OpenReloading/AutoLever/docs/index.md

---
title: Introduction
hide: [navigation, toc]
---

<div class="hero-label">Pre-release, October 2026</div>

# AutoLever: pneumatic drive for the Lee APP

!!! danger "Safety"

    --8<-- "safety.md"

Give your Lee APP an air-powered upgrade. AutoLever takes over the lever work for sizing and decapping. Press START and a Festo cylinder keeps it cycling, stroke after stroke. Press START again when you’re done.

[Start with the BOM](bom.md){ .md-button .md-button--primary } [Wiring](wiring.md){ .md-button }

!!! warning "Status"

    Nothing has been built yet, the printed parts are not on MakerWorld yet, details will change. The StamPLC firmware and wiring have passed their automated tests only; the bench check on the real unit is still open.

!!! note "Relay edition (deprecated prototype)"

    The first prototype used four relays and a timer. Its guide stays as the [relay edition](relay.md) until the parts are removed; do not start a new build from it.

- **One controller, two sensors.** An M5Stack StamPLC runs the sequence.
- **Open firmware.** Flash it once over USB-C with PlatformIO; later updates go over Wi-Fi.
- **Free plans.** Bring your press and build your own.
- **7 to 10 bar** compressed-air supply

Built by reloaders for reloaders, with AI as a tool.

## What it does

- **Automatic cycling.** Press START once for continuous out-and-back strokes. Press it again to stop after the current stroke.
- **JOG control.** With automatic mode off, hold JOG to cycle. Release it to stop.
- **Free at rest.** The cylinder vents when the valve is off, so you can move the lever by hand.
- **Cycle monitoring.** A stroke that takes longer than the jam time (15 s, set between 2 and 120 s on the web page) stops the press, in automatic mode and in JOG, until you press A. Both sensors on at once is a sensor fault.
- **Pressure trip.** The pressure switch cuts power to the valves at 6 bar.
- **Cycle counter.** The display and the web page show the cycles, kept across power-off.
- **Web page.** The StamPLC opens its own Wi-Fi and joins your home network; the page shows the state and sets the jam time. Password and address are on the info screen.
- **24 V throughout.** An enclosed external power supply powers the controls.

## At the controls

POWER and the three buttons under the display:

1. **POWER** on.
2. **A** starts and stops automatic cycling.
3. **B** jogs while held.
4. **C** shows the info screen.

E-STOP cuts the power to the valves (the StamPLC stays on and shows the fault); twist to release. A supply fault clears itself when the power is back; after a jam or a sensor fault, press A, also when E-STOP or the pressure switch tripped in between. Release JOG after any stop or trip. A held JOG never starts the press; release it and press it again.

Check the printed handle adapter for cracks before each session.

## What you’ll need

- A Lee APP (Classic preferred; Deluxe also works).
- A compressed-air supply at 7 to 10 bar.
- The BOM parts, plus a printed handle adapter, control box and yellow E-STOP ring, and a computer with [PlatformIO](https://platformio.org/) to flash the StamPLC (project folder `firmware/` in the repository).

## Print it

PETG or ASA. Handle adapter: 6 walls and 40% infill. Control box: 15–20% infill. The base and lid fit on a 256 mm bed. Print the E-STOP ring in yellow.

!!! danger "Safety"

    --8<-- "safety-short.md"

## Build it

1. Print the parts and gather the components from the [BOM](bom.md).
2. Mount the press, cylinder, valve and filter-regulator on a board. Clamp the handle adapter onto the press lever.
3. Follow the [Wiring](wiring.md) and [Tubing](tubing.md) guides to connect everything.
4. Flash the bench image (`pio run -e bench -t upload` in `firmware/`): it shows BENCH and all eight inputs live, and A, B and C toggle relays 1, 2 and 3. All relays switch off by themselves once one has been on for 10 s, and while input 3 or 4 is off. Set the sensors with air disconnected: POWER on, move the rod by hand. Then flash the press firmware (`pio run -e stamplc -t upload`) and test with air at 2 bar using JOG before trying START.

## Update it

Later updates go over Wi-Fi, once the press firmware is on the StamPLC (the bench image has none). The display must show IDLE: the update is closed while the press runs, jogs or shows a fault. Press C and run in `firmware/`, with the password from the **Pass** line:

    PLATFORMIO_UPLOAD_FLAGS=--auth=PASSWORD pio run -e stamplc -t upload --upload-port autolever.local

This form is for Linux and macOS shells. In PowerShell, run `$env:PLATFORMIO_UPLOAD_FLAGS="--auth=PASSWORD"` once in the session, then the same `pio` command without the prefix.

PlatformIO warns that it switched to `espota`; that is expected. If `autolever.local` is not found, use the address on the **Home** line; when Home shows `-`, join the StamPLC's own Wi-Fi (the **Wi-Fi** line) and use `192.168.4.1`. The StamPLC connects back to your computer during the upload, so allow it if a firewall asks. USB-C stays the recovery path: if an update fails or the press does not start, flash it as in step 4.

<div class="change-it" markdown>

## Change it

Edit `data/*.yaml`, run `.venv/bin/python main.py` and commit `data/buildguide.json`. Printable parts are in `cad/`.

    python -m venv .venv && .venv/bin/pip install -r requirements.txt
    .venv/bin/python main.py
    .venv/bin/mkdocs serve

</div>
