OpenReloading/AutoLever/docs/relay.md

---
hide: [navigation, toc]
---

# Wiring (relay edition)

!!! danger "Safety"

    --8<-- "safety-short.md"

    The full warning is on the [introduction page](index.md).

!!! warning "Deprecated prototype"

    This is the prototype with four relays and a jam timer. It is kept until the relays and the timer are removed from the project, then this page goes too. Build the [StamPLC edition](wiring.md) instead; the parts for this one are in the BOM under "Relay edition only".
