OpenReloading/AutoLever/docs/tubing.md

---
title: Tubing
hide: [navigation, toc, footer]
---

<div id="assembly-guide" data-page="tubing"><noscript>This guide needs JavaScript.</noscript></div>
{{ guide_data() }}
<script src="../assets/guide.js" defer></script>
