OpenReloading/AutoLever/docs/assets/boxes/control_box.png

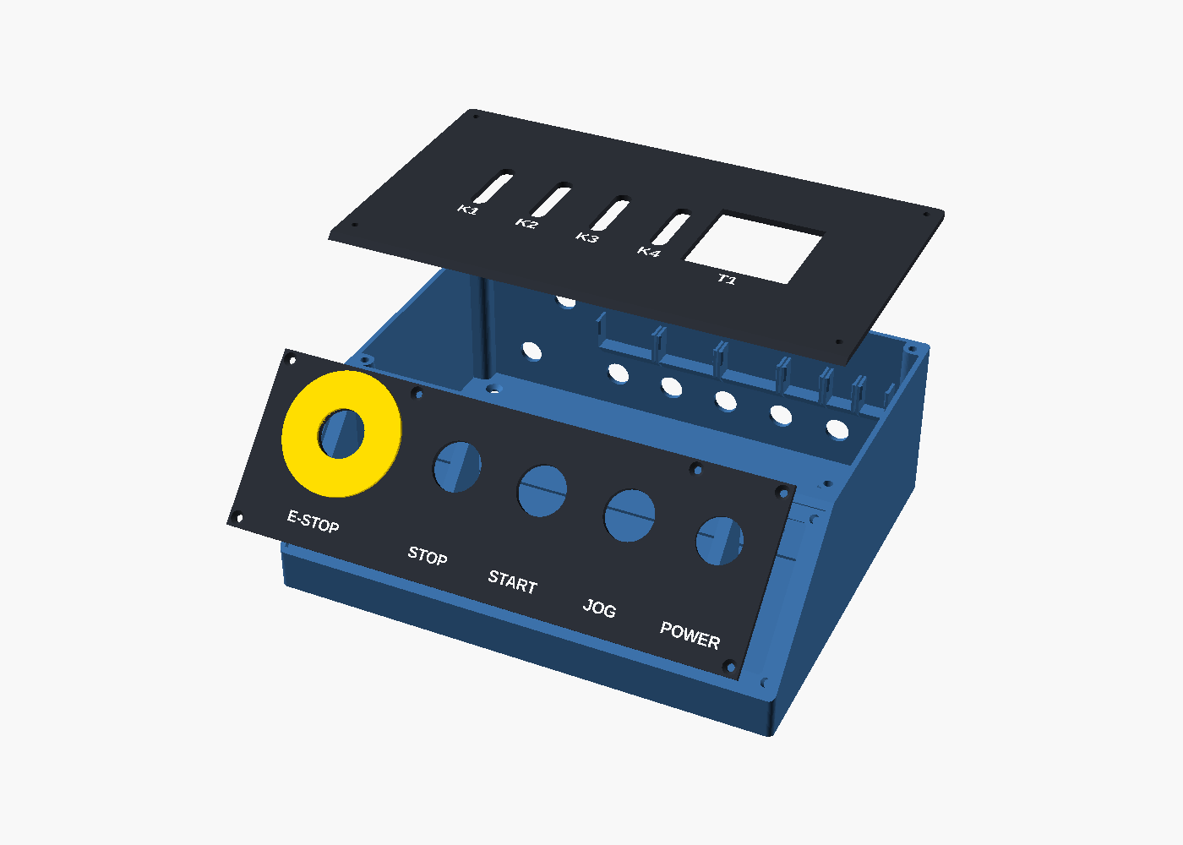
docs/assets/boxes/control_box.png
