OpenReloading/AutoLever/docs/assets/boxes/lee_app_handle_adapter.png

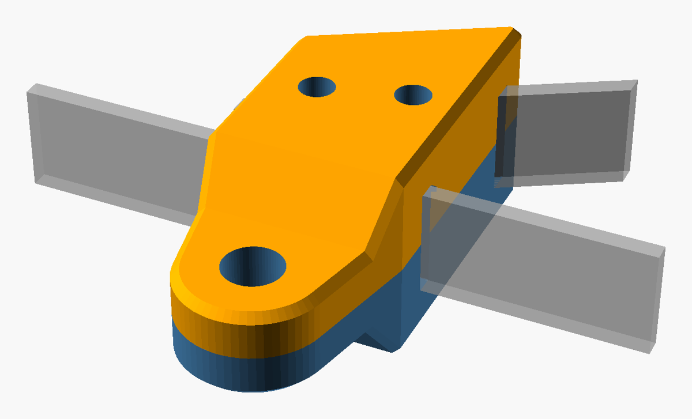
docs/assets/boxes/lee_app_handle_adapter.png
