OpenReloading/AutoLever/docs/assets/social-card.png

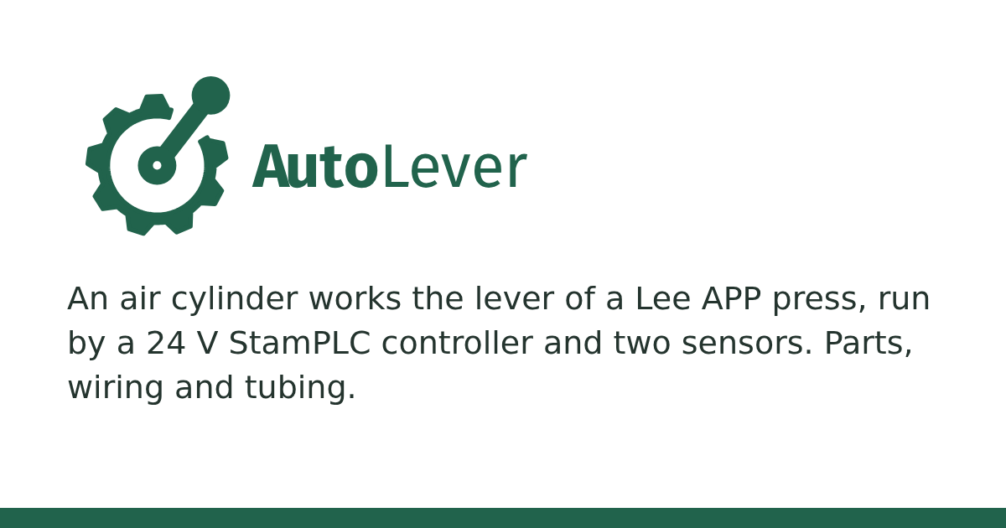
docs/assets/social-card.png
