OpenReloading/AutoLever/docs/bom.md

---
hide: [navigation, toc]
---

# BOM

!!! danger "Safety"

    --8<-- "safety.md"
