OpenReloading/AutoLever/docs/wiring.md

---
hide: [navigation, toc]
---

<div class="step-label">Build step 3 of 4</div>

# Wiring

!!! danger "Safety"

    --8<-- "safety-short.md"

    The full warning is on the [introduction page](index.md).
