OpenReloading/AutoLever/(commit log)

2026-10-09 Pre-release v0.1.0: build guide (docs only)
    Introduction, BOM, wiring and tubing guide for the AutoLever pneumatic drive, published before the first build. CAD stays private until the parts are on MakerWorld.
2026-10-09 Red pre-release banner on every page, shorter README
    [guide.yaml]
2026-10-09 AutoLever logo: even tooth pitch, shorter lever
2026-10-09 AutoLever logo: ring-cut gap, symmetric teeth
2026-10-21 feat: build guide from the BuildGuide MkDocs plugin (#5)
    * feat: build guide from the BuildGuide MkDocs plugin
    main.py writes data/buildguide.json (BuildGuide data format) from
    data/*.yaml and keeps the project rules (labels, cable kinds, twin
    ferrules, two wires per screw). The buildguide plugin replaces
    mkdocs-macros, the site's own renderer, guide.css and the vendored
    JointJS and libavoid. Tubing becomes a routed board.
    repo_url is dropped: Material fetched repo stats from the GitHub API
    on every page. A PR workflow runs the data freshness check, the strict
    build and the browser check.
    Refs #4
    Assisted-by: generative AI
    * feat: short safety warning on board pages, no pre-release bann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
2026-10-21 ci: pin the Pages workflow, least-privilege permissions (#6)
    Actions pinned by commit SHA (checkout v7.0.1, upload-pages-artifact
    v5.0.0, deploy-pages v5.0.1), permissions per job, checkout without
    persisted credentials, system Python 3.12 instead of setup-python.
    zizmor: 7 findings to 0.
    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
2026-10-22 refactor: docs on plain Material pages with BuildGuide components (#10)
2026-10-23 build: install the BuildGuide MkDocs plugin from the v0.1.0 release wheel (#13)
2026-10-24 feat: show tube texts and checks in the tubing guide (#24)
2026-10-24 fix: resolve open SonarCloud findings (#32)
2026-10-25 style(docs): phone-readable wiring and tubing boards (#53)
2026-10-25 style(docs): print stylesheet for the build sheet (#56)
2026-10-25 feat(cad): DIN rail on heat-set inserts, optional wood-screw holes (#60)
2026-10-26 fix(cad): guard adapter pivot eye overlap, space print_plate by real X extent (#62)
2026-10-26 test(cad): pin the default print_plate spacing (#65)
2026-10-27 feat(wiring): plain words, red and black wires, twin ferrules in one step (#73)
2026-10-28 feat(cad): StamPLC control box with the whole unit front in a lid window (#84)
    Refs #72
2026-10-28 docs(guide): StamPLC edition as the main guide, relay edition deprecated (#72) (#87)
2026-10-28 ci(test): add a coverage report and SonarCloud project settings (#89)
2026-10-29 feat(docs): step label, title and token colours on the BOM, wiring and tubing pages (#106)
2026-10-29 fix(docs): 44 px header buttons, search field and card links, checked at 390 and 1440 px (#107)
2026-10-29 refactor(tools): type-check tools/ and drop the unused cable_of argument (#112)
2026-10-29 feat(docs): pinch zoom on the boards with BuildGuide 0.1.4 (#114)
2026-10-29 fix(firmware): write the relays before the web server runs (#124)
2026-10-29 fix(firmware): keep a jam or sensor fault latched under a supply fault (#125)
2026-10-29 fix(docs): give the progress buttons 12 px text and 44 px height at every width (#127)
2026-10-29 test(cad): cover state and fault names, reject an unknown CAD part (#129)
2026-10-29 test(firmware): cover the jam timer across the millis wrap (#137)
2026-11-01 test(firmware): share the stuck-rod loop in the logic tests (#151)
2026-11-12 ci: 3-day Dependabot cooldown, dev container built in CI with the Playwright pin of requirements.in (#155)
2026-11-12 fix(firmware): bench image switches relays off by itself (#158)
